argulab/G450C-digital-console/imagen_1_consolaCDE.jpg

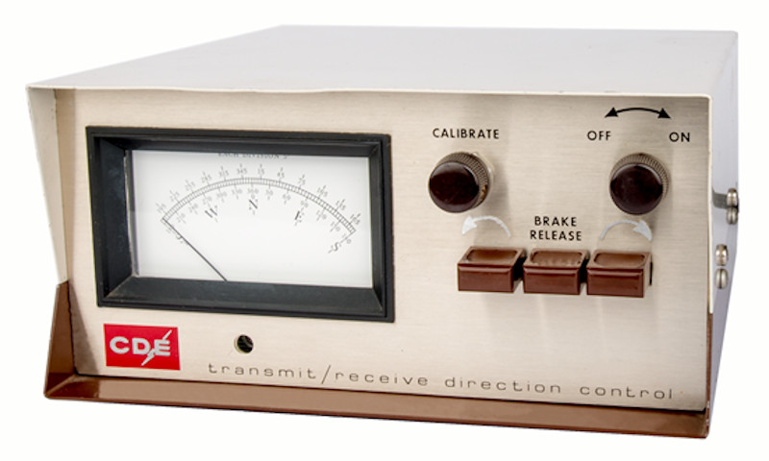
imagen_1_consolaCDE.jpg
