argulab/G450C-digital-console/imagen_3_Circuito del modulo regulador de tension_.jpg

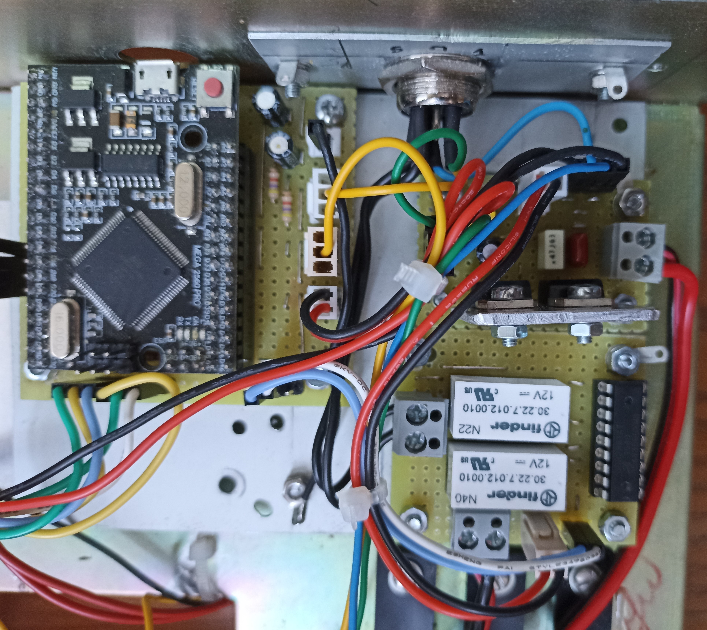
imagen_3_Circuito del modulo regulador de tension_.jpg
