argulab/G450C-digital-console/imagen_2_fuente_meanwell.jpg

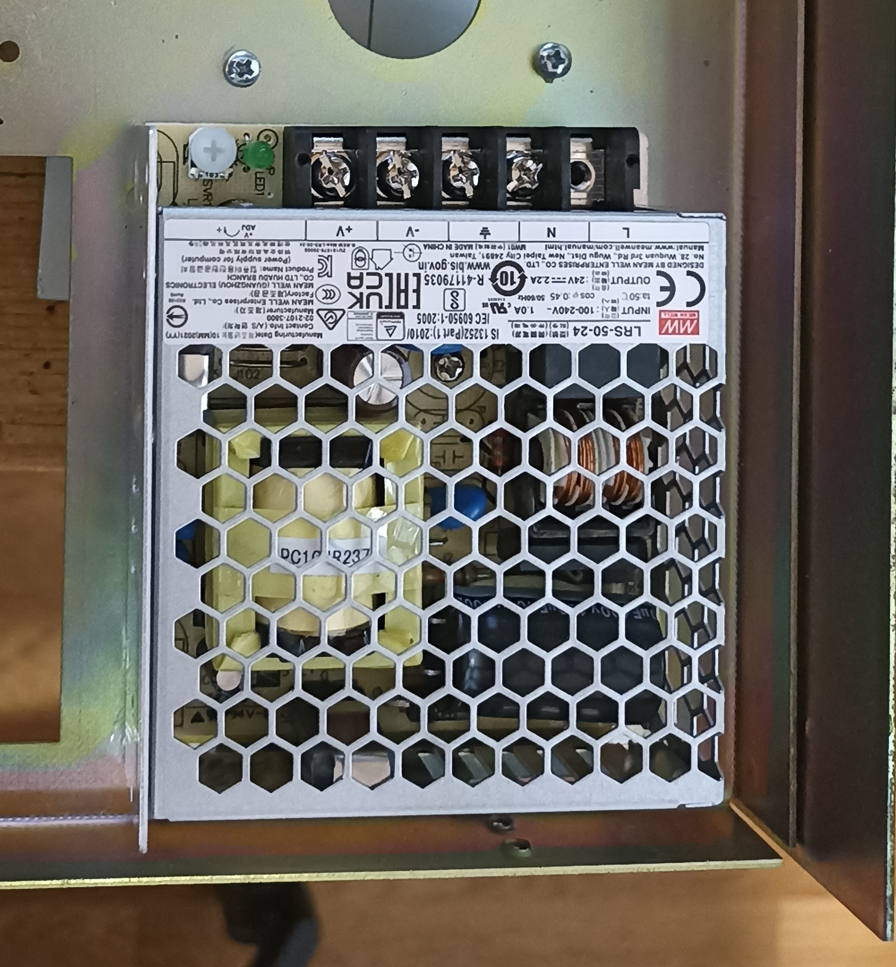
imagen_2_fuente_meanwell.jpg
