argulab/G450C-digital-console/imagen_4_circuito_modulo_regulador_de_tension.jpg

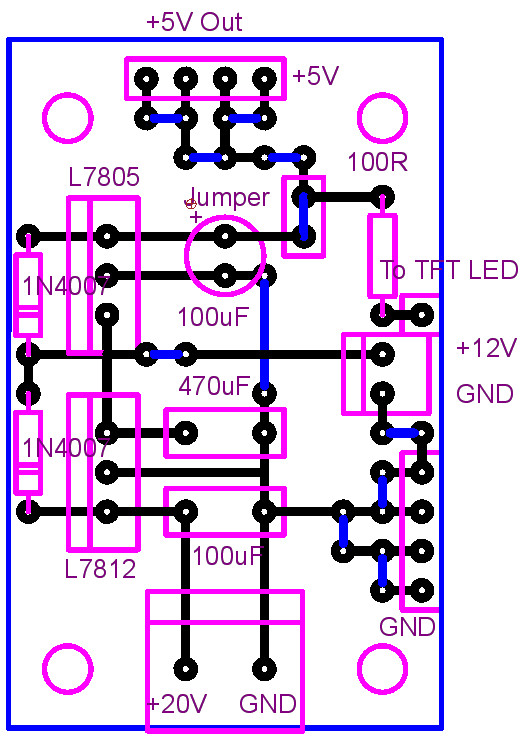
imagen_4_circuito_modulo_regulador_de_tension.jpg
