argulab/G450C-digital-console/imagen_5_circuito_del_modulo_del_mCU.jpg

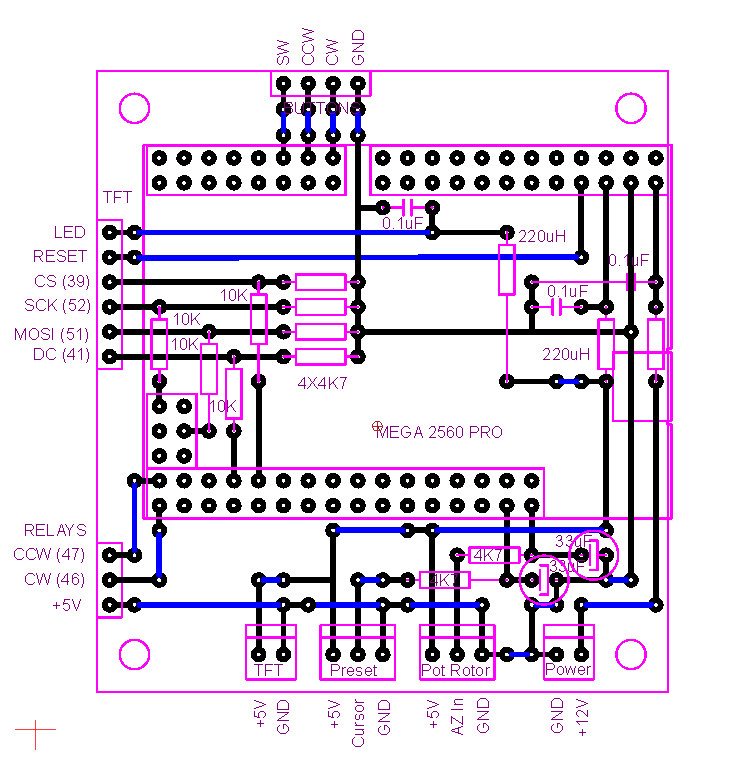
imagen_5_circuito_del_modulo_del_mCU.jpg
