argulab/G450C-digital-console/imagen_6_oircuito del modulo de reles.jpg

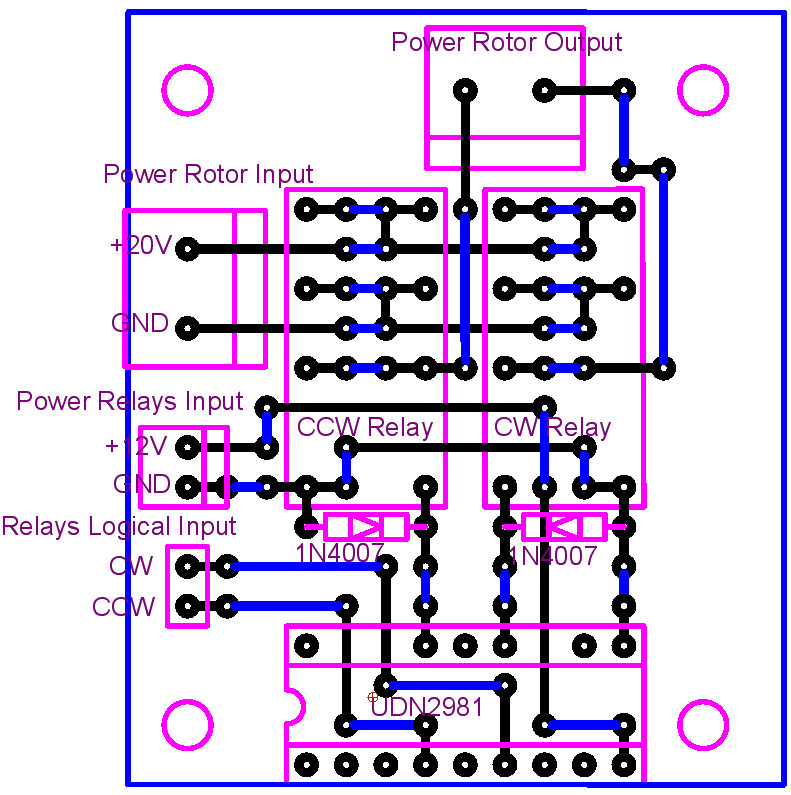
imagen_6_oircuito del modulo de reles.jpg
