argulab/G450C-digital-console/imagen_8_esquema_pantalla.jpg

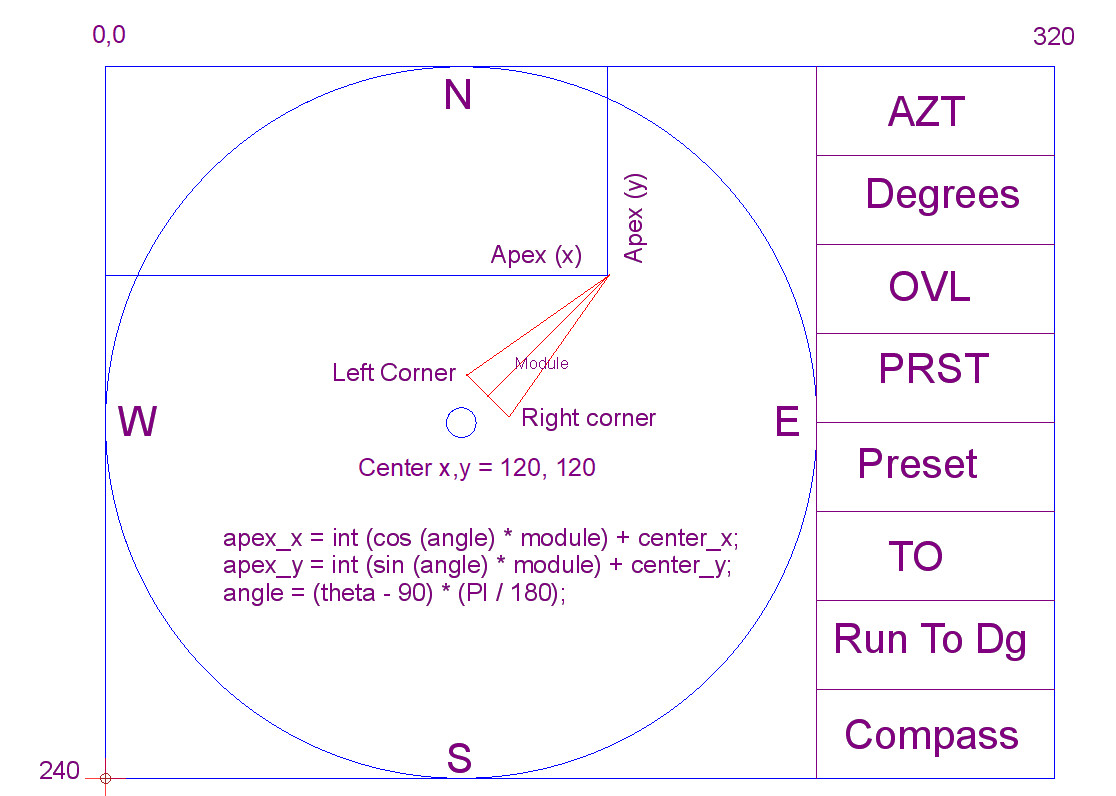
imagen_8_esquema_pantalla.jpg
