argulab/G450C-digital-console/imagen_9_diagrama_de_flujo.jpg

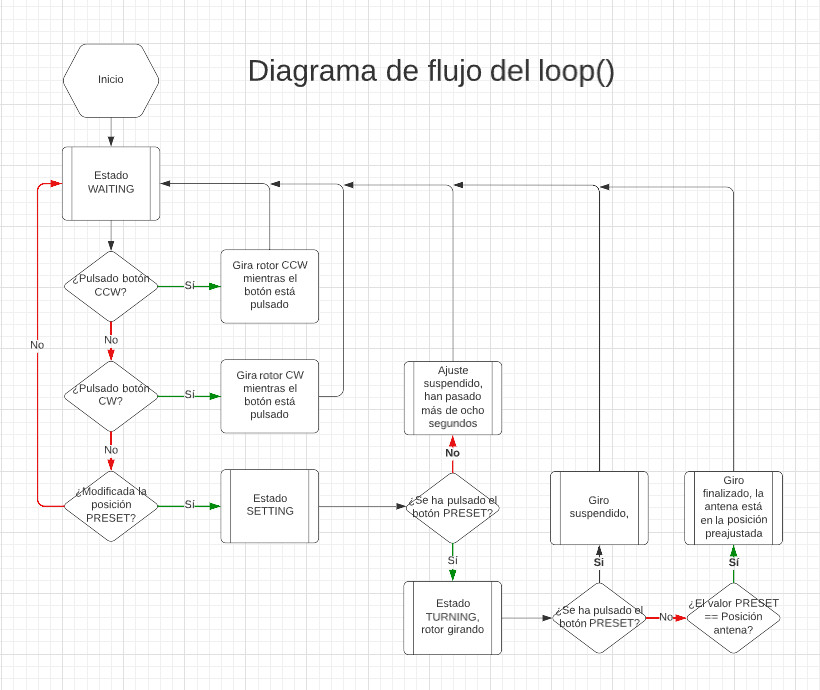
imagen_9_diagrama_de_flujo.jpg
